BommisettyGanesh/cvw/1tops_soc/src2/README.md

# 1TOPS SoC

A minimal RISC-V SoC based on the [CORE-V-Wally](https://github.com/openhwgroup/cvw) (CVW) processor, tailored for hardware synthesis and accelerator integration. The core runs a bare **rv32i** instruction set — FPU, caches, MDU, branch predictors, TLBs, and crypto/bitmanip extensions have all been stripped out to provide the smallest possible footprint for SoC generation.

## SoC Architecture

The SoC uses an **AHB-Lite** interconnect to connect the pipelined core, uncore peripherals, and a custom hardware accelerator.

```text
                                +-------------------------------------------------------+
                                |                                                       |
                                |                       RV32 Core                       |
                                |                        (rv32i)                        |
                                |                                                       |
                                +---------------------------+---------------------------+
                                                            |
                                                      AHB-Lite Bus
                                                            |
          +-------------------------+-----------------------+-----------------------+-------------------------+
          |                         |                       |                       |                         |
  +-------+-------+         +-------+-------+       +-------+-------+       +-------+-------+         +-------+-------+
  |   Boot ROM    |         |   Instr RAM   |       |   Data RAM    |       |  AHB-to-APB   |         |  Multiplier   |
  | (0x0000_1000) |         | (0x8000_0000) |       | (0x8000_2000) |       |    Bridge     |         | (0x3000_0000) |
  +---------------+         +---------------+       +---------------+       +-------+-------+         +---------------+
                                                                                    |
                                                                                 APB Bus
                                                                                    |
        +-----------------------+-----------------------+---------------------------+---------------------------+-----------------------+
        |                       |                       |                           |                           |                       |
+-------+-------+       +-------+-------+       +-------+-------+           +-------+-------+           +-------+-------+       +-------+-------+
|     UART      |       |     GPIO      |       |      SPI      |           |      SDC      |           |     CLINT     |       |     PLIC      |
| (0x1000_0000) |       | (0x1006_0000) |       | (0x1004_0000) |           | (0x0A00_0000) |           | (0x0200_0000) |       | (0x0C00_0000) |
+---------------+       +---------------+       +---------------+           +---------------+           +---------------+       +---------------+
```

## Memory Map

| Start Address | End Address | Size | Bus | Peripheral |
|---|---|---|-----|---|
| `0x0000_1000` | `0x0000_1FFF` | 4 KB | AHB | Boot ROM |
| `0x0200_0000` | `0x0200_FFFF` | 64 KB  | APB | CLINT (Timer / SW Interrupts)|
| `0x0A00_0000` | `0x0A00_0FFF` | 4 KB | APB | SDC (Debug Unit / Reserved)  |
| `0x0C00_0000` | `0x0FFF_FFFF` | 64 MB  | APB | PLIC (Interrupt Controller)  |
| `0x1000_0000` | `0x1000_0007` | 8 B | APB | UART (16550-compatible) |
| `0x1004_0000` | `0x1004_0FFF` | 4 KB | APB | SPI |
| `0x1006_0000` | `0x1006_00FF` | 256 B  | APB | GPIO |
| `0x3000_0000` | `0x30FF_FFFF` | 16 MB  | AHB | Multiplier Module |
| `0x8000_0000` | `0x8000_1FFF` | 8 KB | AHB | Instruction RAM |
| `0x8000_2000` | `0x8000_3FFF` | 8 KB | AHB | Data RAM |

## Directory Structure

```
1tops_soc/
├── config/              # Configuration headers (config.vh, parameter-defs.vh)
├── fpga/                # Standalone FPGA implementation targeting Digilent Basys 3
│   ├── constrs/         # Physical pin constraints (basys3.xdc)
│   ├── src/             # FPGA-tuned RTL sources (BRAM inference, debugger)
│   ├── top/             # wally_soc_fpga_top.sv top-level wrapper
│   ├── build_fpga.tcl   # Automated Vivado build script
│   └── README.md        # FPGA board guide, HTerm serial terminal setup, and demos
├── schematics/          # Vivado project & TCL scripts for RTL schematic viewing
├── software/            # Bare-metal test programs, linker script, startup code
│   ├── main.c           # Accelerator C test program
│   ├── factorial.S      # Bare-metal RV32I factorial demo for FPGA testing
│   ├── crt0.S           # Startup assembly
│   ├── link.ld          # Linker script
│   └── Makefile
├── src/                 # RTL source (SystemVerilog)
│   ├── accelerator/     # Custom AHB accelerators (multiplier_ahb.sv)
│   ├── debugger/        # Hardware debugger (UART, FT1248, ADP controller, AHB arbiter)
│   ├── ebu/             # External Bus Unit (AHB-Lite arbiter)
│   ├── generic/         # Flops, muxes, memories (ram1p1rwbe.sv)
│   ├── hazard/          # Pipeline hazard unit with ExternalStall core freeze
│   ├── ieu/             # Integer Execution Unit (ALU, controller, regfile)
│   ├── ifu/             # Instruction Fetch Unit
│   ├── lsu/             # Load-Store Unit
│   ├── mmu/             # Memory Management Unit (address decoders, PMA/PMP)
│   ├── privileged/      # CSRs, trap handling, privilege modes
│   ├── uncore/          # SoC peripherals (UART, GPIO, SPI, CLINT, PLIC, RAM, ROM)
│   └── wally/           # Top-level SoC and core wrappers (wallypipelinedsoc.sv)
├── testbench/           # Verilator testbench (tb.sv, sim_main.cpp)
├── filelist.f           # Verilator source file list
├── Makefile             # Top-level build: `make` compiles software + runs simulation
└── README.md
```

## Features

- **Pipelined RISC-V Core**: Minimal rv32i instruction set. No FPU, no caches, no MDU, no branch predictors, no TLBs, no compressed/crypto/bitmanip extensions.
- **Dual-Protocol Hardware Debugger**: Integrated ASCII Debug Protocol (ADP) engine supporting both **UART** (115200 baud on PMOD JA) and **FT1248** (high-speed synchronous bus on PMOD JB) with physical switch selection (`dbg_sel`). Auto-enters ADP command prompt (`]`) on boot without requiring an escape character (`0x1B`).
- **Non-Intrusive Core Freeze & Single-Stepping**: Halts the 5-stage CPU pipeline on the fly via `ExternalStall` in `hazard.sv`, granting full AHB-Lite bus mastership to the debugger through `ahb_mux.sv`. Features a dedicated **Core Step Controller** (`core_step_controller.sv`) for single instruction stepping (`C 0204`) and clock-cycle stepping (`C 020c`).
- **Reconfigurable In-Flight Clock Dividers**: Isolated hardware configuration registers allow dynamic, glitch-free reconfiguration of the UART baud rate divider and FT1248 clock divider via ADP commands `B` and `D`.
- **Subword-Accurate Memory Access**: `HWSTRB` dynamic byte/halfword/word strobe decoding enables clean byte streaming via binary upload (`U`) without corrupting neighboring memory words.
- **Dedicated FPGA Implementation (Basys 3)**: Synthesizes instruction RAM (`ram_i`) and data RAM (`ram_d`) into dedicated hardware `RAMB36E1` Block RAM primitives. Includes synchronous UART RX monitoring and prompt detection on LED 15 (`led_rx_detect`).
- **AHB-Lite Interconnect**: Standard bus interface for attaching IP blocks.
- **External Accelerator Support**: Dedicated AHB region at `0x3000_0000` for custom accelerators (currently a hardware multiplier).
- **Full Uncore**: UART, GPIO, SPI, CLINT, PLIC, Boot ROM, and Independent Instruction/Data RAMs are all present and functional.
- **Independent RAMs**: 16KB total, mapped at `0x8000_0000` (8KB Instruction RAM) and `0x8000_2000` (8KB Data RAM), initialized from `test_instr.mem` and `test_data.mem` during simulation.

## Integrating an Accelerator

Custom accelerators are integrated directly into the SoC as **AHB Slaves** inside the uncore module.

1. **Create an AHB Slave**: Write a SystemVerilog module with an AHB slave interface (see `src/accelerator/multiplier_ahb.sv` for reference).
2. **Instantiate in the Uncore**: Add the module inside `src/uncore/uncore.sv`, connecting to the internal `H*EXT` signals (`HRDATAEXT`, `HSELEXT`, etc.).
3. **Add to filelist**: Add the new `.sv` file path to `filelist.f`.
4. **Access from Software**: Use memory-mapped I/O at `0x3000_0000` in your C code.

### Multiplier Module Registers

| Offset | Register | Description |
|---|---|---|
| `0x00` | OPA | Operand A (write) |
| `0x04` | OPB | Operand B (write) |
| `0x08` | RESULT | Product A×B (read) |
| `0x0C` | PRINT | Debug char out (write)|

## Simulation & Testing

The repository includes a simulation environment using **Verilator**.

### Quick Start

From the root of the repository (`1tops_soc/`):

```bash
make
```

This single command will:
1. Clean and compile `software/main.c` into `test_instr.mem` and `test_data.mem` hex files.
2. Clean and compile the Verilator hardware simulation model.
3. Execute the full SoC testbench and print C code outputs to your terminal.

> [!NOTE]
> **Full SoC Simulation**: The simulation includes the **entire Wally pipelined SoC** — all standard peripherals (PLIC, CLINT, UART, GPIO, SPI) remain intact and fully simulated within the uncore.

### Writing Your Own Test

1. Edit `software/main.c` with your C program.
2. Use `volatile uint32_t*` pointers to `0x3000_0000` to interact with the accelerator.
3. Run `make` from the repo root.

## Viewing RTL Schematics in Vivado

The `schematics/` directory includes scripts to visualize the RTL in Xilinx Vivado:

```bash
cd schematics
./open_vivado.sh
```

This creates a Vivado project, adds all sources, elaborates the RTL, and opens the schematic viewer. See `schematics/README.md` for details.
## 4. Tsetlin Machine Accelerator & Debug Unit Integration

### Tsetlin Machine Integration (`0x3000_0000`)
The system is explicitly designed to act as a bare-metal controller for an external Convolutional Tsetlin Machine.
The accelerator space is mapped to `0x3000_0000` - `0x30FF_FFFF` (16MB).
Because it uses the `EXT_MEM` parameter configuration, any memory access by the core to this region is automatically routed out of the top-level `wallypipelinedsoc.sv` module via the `HSELEXT` and `HRDATAEXT` pins.

We have provided a template accelerator and testbench to show how this is connected:
- **`src/accelerator/tsetlin_ahb_wrapper.sv`**: A mock SystemVerilog AHB peripheral mapped to `0x3000_0000`. You should put your actual Tsetlin Machine logic in this file (or replace it).
- **`filelist.f`**: This manifest includes `src/accelerator/*.sv` so your accelerator is automatically picked up by Vivado and Verilator.
- **`testbench/tb.sv`**: This is the top-level testbench that instantiates both `wallypipelinedsoc` and `tsetlin_ahb_wrapper`, connecting the exported AHB pins (`HSELEXT`, `HADDREXT`, etc.) directly to the accelerator.

### Debug Unit Integration
The `SDC` APB peripheral slot has been repurposed as a placeholder for a custom Debug Unit.
In `src/uncore/uncore.sv`, look for the `debug_unit` block. You can connect your custom debug module directly to the APB bus signals `PSEL[5]`, `PADDR`, `PWDATA`, and `PRDATA[5]` located there.

---

## 5. Software C-Compilation & Verilator Simulation

This repository includes a bare-metal C toolchain scaffold and a Verilator simulator driver so you can write C code, compile it, and run it against the RTL (and your accelerator).

### 1. Writing C Code (`software/`)
The `software/` directory contains everything you need to write and compile code for the `1tops_soc`:
- `main.c`: Your main application. It demonstrates how to print to the UART (`0x1000_0000`) and how to read/write memory-mapped registers in the Tsetlin Accelerator (`0x3000_0000`).
- `link.ld`: A minimal linker script mapping code to the Instruction RAM and data to the Data RAM.
- `crt0.S`: Assembly startup script to initialize the stack and jump to `main`.
- `Makefile`: Uses `riscv64-unknown-elf-gcc` to compile the C files and generates `test_instr.mem` and `test_data.mem` hex files.

### 2. Simulating with Verilator (`testbench/`)
The `testbench/` directory contains a complete simulation environment.

**Prerequisites:**
You need `verilator` and `riscv64-unknown-elf-gcc` installed on your machine.

**Running the Simulation:**
Navigate to the testbench directory and run `make run` (or just `make` from the repository root):
```bash
make
```

**What happens when you type `make`:**
1. It builds the Verilator C++ model of `tb.sv` (which includes the SoC and the Accelerator).
2. It copies the `software/test_instr.mem` and `software/test_data.mem` (your compiled C code) into the testbench directory.
3. It runs the simulation. The internal `ram_ahb.sv` memory modules use `$readmemh` to preload your C code into the Instruction and Data SRAMs.
4. The simulation executes, and a `trace.vcd` waveform is generated (limited to AHB signals to reduce size) for debugging in GTKWave!

---

## 6. Dedicated FPGA Implementation & Hardware Debugger (Basys 3)

The `fpga/` directory provides a ready-to-synthesize implementation for the **Digilent Basys 3** board (`xc7a35tcpg236-1`).

### Physical Hardware Pinout

| Port Name | Board Location | Direction | Function |
| :--- | :--- | :---: | :--- |
| `clk` | **Pin W5** | Input | 100 MHz oscillator (MMCM generates 50 MHz `clk_soc`) |
| `reset_btn` | **Pin U18 (btnC)** | Input | Center pushbutton (active-high system reset) |
| `dbg_sel` | **Pin V17 (SW0)** | Input | Slide switch: `0` (Down) = UART, `1` (Up) = FT1248 |
| `uart_rx` | **PMOD JA Pin 1 (J1)** | Input | Debugger UART RX (connect to USB-UART Dongle TXD) |
| `uart_tx` | **PMOD JA Pin 2 (L2)** | Output | Debugger UART TX (connect to USB-UART Dongle RXD) |
| `ft1248_clk` | **PMOD JB Pin 1 (A14)** | Output | FT1248 Serial Clock (SCLK to FT232H) |
| `ft1248_ss_n` | **PMOD JB Pin 2 (A16)** | Output | FT1248 Active-Low Chip Select (SS# to FT232H) |
| `ft1248_miso` | **PMOD JB Pin 3 (B15)** | Input | FT1248 Read Available Status (MISO / RXF# from FT232H) |
| `ft1248_miosio` | **PMOD JB Pin 4 (B16)** | Inout | FT1248 Bidirectional Serial Data Bus |
| `led_core_halted` | **Pin U16 (LED 0)** | Output | Status LED (lit when CPU core is halted by debugger) |
| `led_dbg_sel` | **Pin E19 (LED 1)** | Output | Status LED (lit when FT1248 mode is selected) |
| `led_rx_detect` | **Pin L1 (LED 15)** | Output | UART RX Activity / Prompt `]` Detector (Blinks ~200ms on any byte, latches ON upon detecting `]`) |

### Serial Terminal Interaction (HTerm)

Configure HTerm with **115200 Baud, 8 Data Bits, 1 Stop Bit, No Parity, No Flow Control**:

1. **Boot Banner & Direct Auto-Prompt**:
   On power-on or pressing reset button `btnC`, the debugger outputs:
   ```text
    0x50c1ab04
   ]
   ```
   LED 15 turns solidly ON. **No escape character (`0x1B`) is required!**

2. **Execute Commands**:
   Set input to **`ASC`** with **Send on Enter = `CR`**:
   - `C 0202` — Halt CPU pipeline (`led_core_halted` turns ON).
   - `C 0204` / `C 0104` — Single-step 1 retired instruction.
   - `C 020c` / `C 010c` — Single-step 1 clock cycle.
   - `C` — Query status (Bit 0 = Halted, Bit 1 = Step Busy, Bit 2 = Step Done).
   - `B` — Query UART and FT1248 clock dividers (`0x00<FT8><UART16>`).
   - `B <hex16>` — Set UART baud divider (e.g., `B 00d9` for 230,400 baud at 50 MHz).
   - `D` / `D <hex8>` — Query / set FT1248 clock divider.
   - `A <hex_addr>` — Set 32-bit AHB address pointer.
   - `R` / `W <data>` — Read or write 32-bit word at current pointer.
   - `F <count>` — Fill `<count>` words with reference value in `V`.
   - `U <count>` — Stream `<count>` raw binary bytes sequentially into memory.
   - `C 0201` / `C 0101` — Assert / deassert CPU reset vector.
   - `C 0102` — Resume CPU pipeline execution.
   - `X` — Exit back to terminal passthrough mode.

### Bare-Metal Factorial Demo (`software/factorial.S`)

To test the core, memory, and debugger end-to-end:
1. Compile the demo: `cd software && make factorial.bin` (produces 76-byte `factorial.bin`).
2. Halt CPU: `C 0202`
3. Zero instruction memory: `A 80000000` $\rightarrow$ `V 00000000` $\rightarrow$ `F 200`
4. Set input $n = 5$ at Data RAM `0x80002000`: `A 80002000` $\rightarrow$ `W 00000005` $\rightarrow$ `W 00000000`
5. Upload program: `A 80000000` $\rightarrow$ `U 4c` $\rightarrow$ send `factorial.bin` via HTerm **Send File**.
6. Restart and run: `C 0201` $\rightarrow$ `C 0101` $\rightarrow$ `C 0102`
7. Halt and check result: `C 0202` $\rightarrow$ `A 80002004` $\rightarrow$ `R` $\rightarrow$ replies `R 0x00000078` ($120_{10} = 5!$).

For detailed guides, see:
- [fpga/README.md](file:///home/ganesh/Desktop/shri/cvw/1tops_soc/fpga/README.md) — Basys 3 board implementation and bitstream build
- [fpga/STEP_AND_CLOCK_DIV_VERIFICATION_GUIDE.md](file:///home/ganesh/Desktop/shri/cvw/1tops_soc/fpga/STEP_AND_CLOCK_DIV_VERIFICATION_GUIDE.md) — Detailed core stepping and clock division verification guide
- [src/debugger/COMMANDS.md](file:///home/ganesh/Desktop/shri/cvw/1tops_soc/src/debugger/COMMANDS.md) — Complete ADP command reference and cheatsheet
