BommisettyGanesh/cvw/1tops_soc/src2/uncore/spi_apb.sv

// spi_apb.sv
// Purpose: SPI peripheral

module spi_apb #(
  parameter XLEN = 32,
  parameter SPI_LOOPBACK_TEST = 0
)(
  input  logic                PCLK, PRESETn,
  input  logic                PSEL,
  input  logic [7:0]          PADDR,
  input  logic [XLEN-1:0]     PWDATA,
  input  logic [XLEN/8-1:0]   PSTRB,
  input  logic                PWRITE,
  input  logic                PENABLE,
  output logic                PREADY,
  output logic [XLEN-1:0]     PRDATA,
  output logic                SPIOut,
  input  logic                SPIIn,
  output logic [3:0]          SPICS,
  output logic                SPIIntr,
  output logic                SPICLK
);

  // register map
  localparam SPI_SCKDIV =  8'h00;
  localparam SPI_SCKMODE = 8'h04;
  localparam SPI_CSID =    8'h10;
  localparam SPI_CSDEF =   8'h14;
  localparam SPI_CSMODE =  8'h18;
  localparam SPI_DELAY0 =  8'h28;
  localparam SPI_DELAY1 =  8'h2C;
  localparam SPI_FMT =     8'h40;
  localparam SPI_TXDATA =  8'h48;
  localparam SPI_RXDATA =  8'h4C;
  localparam SPI_TXMARK =  8'h50;
  localparam SPI_RXMARK =  8'h54;
  localparam SPI_IE =      8'h70;
  localparam SPI_IP =      8'h74;

  // SPI control registers. Refer to SiFive FU540-C000 manual
  logic [11:0] SckDiv;
  logic [1:0]  SckMode;
  logic [1:0]  ChipSelectID;
  logic [3:0]  ChipSelectDef;
  logic [1:0]  ChipSelectMode;
  logic [15:0] Delay0, Delay1;
  logic [4:0]  Format;
  logic [7:0]  ReceiveData;
  logic [8:0]  TransmitData;
  logic [2:0]  TransmitWatermark, ReceiveWatermark;
  logic [1:0]  InterruptEnable, InterruptPending;

  // Bus interface signals
  logic [7:0]  Entry;
  logic        Memwrite;
  logic [31:0] Din,  Dout;

  // SPI Controller signals
  logic        SCLKenable;
  logic        EndOfFrame;
  logic        Transmitting;
  logic        InactiveState;
  logic [3:0]  FrameLength;

  // Starting Transmission and restarting SCLKenable
  logic        ResetSCLKenable;
  logic        TransmitStart;
  logic        TransmitStartD;

  // Transmit Start State Machine Variables
  typedef enum logic [1:0] {READY, START, WAIT} txState;
  txState CurrState, NextState;

  // FIFO Watermark signals - TransmitReadMark = ip[0], ReceiveWriteMark = ip[1]
  logic        TransmitWriteMark, TransmitReadMark, ReceiveWriteMark, ReceiveReadMark;

  // Transmit FIFO Signals
  logic        TransmitFIFOFull, TransmitFIFOEmpty;
  logic        TransmitFIFOWriteInc;
  logic        TransmitFIFOReadInc;                // Increments Tx FIFO read ptr 1 cycle after Tx FIFO is read
  logic [7:0]  TransmitReadData;

  // ReceiveFIFO Signals
  logic        ReceiveFIFOWriteInc;
  logic        ReceiveFIFOReadInc;
  logic        ReceiveFIFOFull, ReceiveFIFOEmpty;

  /* verilator lint_off UNDRIVEN */
  logic [2:0]  TransmitWriteWatermarkLevel, ReceiveReadWatermarkLevel; // unused generic FIFO outputs
  /* verilator lint_on UNDRIVEN */
  logic [7:0]  ReceiveShiftRegEndian;              // Reverses ReceiveShiftReg if Format[2] set (little endian transmission)

  // Shift reg signals
  logic        ShiftEdge;                          // Determines which edge of sck to shift from TransmitReg
  logic        SampleEdge;                         // Determines which edge of sck to sample from ReceiveShiftReg
  logic [7:0]  TransmitReg;                        // Transmit shift register
  logic [7:0]  ReceiveShiftReg;                    // Receive shift register
  logic [7:0]  TransmitDataEndian;                 // Reverses TransmitData from txFIFO if littleendian, since TransmitReg always shifts MSB
  logic        TransmitLoad;                       // Determines when to load TransmitReg
  logic        TransmitRegLoaded;

  // Shift stuff due to Format register?
  logic        ShiftIn;                            // Determines whether to shift from SPIIn or SPIOut (if SPI_LOOPBACK_TEST)
  logic [3:0]  LeftShiftAmount;                    // Determines left shift amount to left-align data when little endian
  logic [7:0]  ASR;                                // AlignedReceiveShiftReg

  // CS signals
  logic [3:0]  ChipSelectAuto;                     // Assigns ChipSelect value to selected CS signal based on CS ID
  logic [3:0]  ChipSelectInternal;                 // Defines what each ChipSelect signal should be based on transmission status and ChipSelectDef

  // APB access
  assign Entry = {PADDR[7:2],2'b00};  //  32-bit word-aligned accesses
  assign Memwrite = PWRITE & PENABLE & PSEL;  // Only write in access phase
  assign PREADY = 1'b1;

  // Account for subword read/write circuitry
  // -- Note SPI registers are 32 bits no matter what; access them with LW SW.

  assign Din = PWDATA[31:0];
  assign PRDATA = (XLEN == 64) ? {Dout, Dout} : Dout;

  // Register access
  always_ff@(posedge PCLK)
    if (~PRESETn) begin
      SckDiv <= 12'd3;
      SckMode <= 2'b0;
      ChipSelectID <= 2'b0;
      ChipSelectDef <= 4'b1111;
      ChipSelectMode <= 2'b0;
      Delay0 <= {8'b1,8'b1};
      Delay1 <= {8'b0,8'b1};
      Format <= {5'b10000};
      TransmitData <= 9'b0;
      TransmitWatermark <= 3'b0;
      ReceiveWatermark <= 3'b0;
      InterruptEnable <= 2'b0;
      InterruptPending <= 2'b0;
    end else begin // writes
      /* verilator lint_off CASEINCOMPLETE */
      if (Memwrite)
        case(Entry) // flop to sample inputs
          SPI_SCKDIV:  SckDiv <= Din[11:0];
          SPI_SCKMODE: SckMode <= Din[1:0];
          SPI_CSID:    ChipSelectID <= Din[1:0];
          SPI_CSDEF:   ChipSelectDef <= Din[3:0];
          SPI_CSMODE:  ChipSelectMode <= Din[1:0];
          SPI_DELAY0:  Delay0 <= {Din[23:16], Din[7:0]};
          SPI_DELAY1:  Delay1 <= {Din[23:16], Din[7:0]};
          SPI_FMT:     Format <= {Din[19:16], Din[2]};
          SPI_TXDATA:  if (~TransmitFIFOFull) TransmitData[7:0] <= Din[7:0];
          SPI_TXMARK:  TransmitWatermark <= Din[2:0];
          SPI_RXMARK:  ReceiveWatermark <= Din[2:0];
          SPI_IE:      InterruptEnable <= Din[1:0];
        endcase
      /* verilator lint_on CASEINCOMPLETE */

      // According to FU540 spec: Once interrupt is pending, it will remain set until number
      // of entries in tx/rx fifo is strictly more/less than tx/rxmark
      InterruptPending[0] <= TransmitReadMark;
      InterruptPending[1] <= ReceiveWriteMark;

      case(Entry) // Flop to sample inputs
        SPI_SCKDIV:  Dout <= {20'b0, SckDiv};
        SPI_SCKMODE: Dout <= {30'b0, SckMode};
        SPI_CSID:    Dout <= {30'b0, ChipSelectID};
        SPI_CSDEF:   Dout <= {28'b0, ChipSelectDef};
        SPI_CSMODE:  Dout <= {30'b0, ChipSelectMode};
        SPI_DELAY0:  Dout <= {8'b0, Delay0[15:8], 8'b0, Delay0[7:0]};
        SPI_DELAY1:  Dout <= {8'b0, Delay1[15:8], 8'b0, Delay1[7:0]};
        SPI_FMT:     Dout <= {12'b0, Format[4:1], 13'b0, Format[0], 2'b0};
        SPI_TXDATA:  Dout <= {TransmitFIFOFull, 23'b0, 8'b0};
        SPI_RXDATA:  Dout <= {ReceiveFIFOEmpty, 23'b0, ReceiveData[7:0]};
        SPI_TXMARK:  Dout <= {29'b0, TransmitWatermark};
        SPI_RXMARK:  Dout <= {29'b0, ReceiveWatermark};
        SPI_IE:      Dout <= {30'b0, InterruptEnable};
        SPI_IP:      Dout <= {30'b0, InterruptPending};
        default:     Dout <= 32'b0;
      endcase
    end

  // SPI Controller module -------------------------------------------
  // This module controls state and timing signals that drive the rest of this module
  assign ResetSCLKenable = Memwrite & (Entry == SPI_SCKDIV);
  assign FrameLength = Format[4:1];

  spi_controller controller(PCLK, PRESETn,
                            // Transmit Signals
                            TransmitStart, TransmitRegLoaded, ResetSCLKenable,
                            // Register Inputs
                            SckDiv, SckMode, ChipSelectMode, Delay0, Delay1, FrameLength,
                            // txFIFO stuff
                            TransmitFIFOEmpty,
                            // Timing
                            SCLKenable, ShiftEdge, SampleEdge, EndOfFrame,
                            // State stuff
                            Transmitting, InactiveState,
                            // Outputs
                            SPICLK);

  // Transmit FIFO ---------------------------------------------------

  // txFIFO write increment logic
  always_ff @(posedge PCLK or negedge PRESETn) begin
    if (~PRESETn) TransmitFIFOWriteInc <= 1'b0;
    else          TransmitFIFOWriteInc <= (Memwrite & (Entry == SPI_TXDATA) & ~TransmitFIFOFull);
  end

  // txFIFO read increment logic
  always_ff @(posedge PCLK or negedge PRESETn) begin
    if (~PRESETn)        TransmitFIFOReadInc <= 1'b0;
    else if (SCLKenable) TransmitFIFOReadInc <= TransmitStartD | (EndOfFrame & ~TransmitFIFOEmpty);
  end

  // Check whether TransmitReg has been loaded.
  // We use this signal to prevent returning to the Ready state for TransmitStart
  always_ff @(posedge PCLK) begin
    if (~PRESETn) begin
      TransmitRegLoaded <= 1'b0;
    end else if (TransmitLoad) begin
      TransmitRegLoaded <= 1'b1;
    end else if (ShiftEdge | EndOfFrame) begin
      TransmitRegLoaded <= 1'b0;
    end
  end

  // Setup TransmitStart state machine
  always_ff @(posedge PCLK)
    if (~PRESETn) CurrState <= READY;
    else          CurrState <= NextState;

  // State machine for starting transmissions
  always_comb begin
    case (CurrState)
      READY: if (~TransmitFIFOEmpty & ~Transmitting) NextState = START;
             else NextState = READY;
      START: NextState = WAIT;
      WAIT: if (~Transmitting & ~TransmitRegLoaded) NextState = READY;
            else NextState = WAIT;
      default: NextState = READY;
    endcase
  end

  // Delayed TransmitStart signal for incrementing tx read point.
  assign TransmitStart = (CurrState == START);
  always_ff @(posedge PCLK)
    if (~PRESETn) TransmitStartD <= 1'b0;
    else if (TransmitStart) TransmitStartD <= 1'b1;
    else if (SCLKenable) TransmitStartD <= 1'b0;

  // Transmit FIFO
  spi_fifo #(3,8) txFIFO(PCLK, 1'b1, SCLKenable, PRESETn,
                         TransmitFIFOWriteInc, TransmitFIFOReadInc,
                         TransmitData[7:0],
                         TransmitWriteWatermarkLevel, TransmitWatermark[2:0],
                         TransmitReadData[7:0],
                         TransmitFIFOFull,
                         TransmitFIFOEmpty,
                         TransmitWriteMark, TransmitReadMark);

  // Receive FIFO ----------------------------------------------------

  // Receive FIFO Read Increment register
  always_ff @(posedge PCLK or negedge PRESETn) begin
    if (~PRESETn) ReceiveFIFOReadInc <= 1'b0;
    else          ReceiveFIFOReadInc <= ((Entry == SPI_RXDATA) & ~ReceiveFIFOEmpty & PSEL & ~ReceiveFIFOReadInc);
  end

  // Receive FIFO Write Increment register
  always_ff @(posedge PCLK or negedge PRESETn) begin
    if (~PRESETn)        ReceiveFIFOWriteInc <= 1'b0;
    else if (SCLKenable) ReceiveFIFOWriteInc <= EndOfFrame;
  end

  // Receive FIFO
  spi_fifo #(3,8) rxFIFO(PCLK, SCLKenable, 1'b1, PRESETn,
                         ReceiveFIFOWriteInc, ReceiveFIFOReadInc,
                         ReceiveShiftRegEndian, ReceiveWatermark[2:0],
                         ReceiveReadWatermarkLevel,
                         ReceiveData[7:0],
                         ReceiveFIFOFull,
                         ReceiveFIFOEmpty,
                         ReceiveWriteMark, ReceiveReadMark);

  // Shift Registers --------------------------------------------------
  // Transmit shift register
  assign TransmitLoad = TransmitStart | (EndOfFrame & ~TransmitFIFOEmpty);
  wire [7:0] TransmitReadDataReversed = {TransmitReadData[0], TransmitReadData[1], TransmitReadData[2], TransmitReadData[3],
                                         TransmitReadData[4], TransmitReadData[5], TransmitReadData[6], TransmitReadData[7]};
  assign TransmitDataEndian = Format[0] ? TransmitReadDataReversed : TransmitReadData[7:0];
  always_ff @(posedge PCLK)
    if(~PRESETn)            TransmitReg <= 8'b0;
    else if (TransmitLoad)  TransmitReg <= TransmitDataEndian;
    else if (ShiftEdge)     TransmitReg <= {TransmitReg[6:0], TransmitReg[0]};

  assign SPIOut = TransmitReg[7];

  // If in loopback mode, receive shift register is connected directly
  // to module's output pins. Else, connected to SPIIn. There are no
  // setup/hold time issues because transmit shift register and receive
  // shift register always shift/sample on opposite edges
  assign ShiftIn = SPI_LOOPBACK_TEST ? SPIOut : SPIIn;

  // Receive shift register
  always_ff @(posedge PCLK)
    if(~PRESETn) begin
      ReceiveShiftReg <= 8'b0;
    end else if (SampleEdge) begin
      ReceiveShiftReg <= {ReceiveShiftReg[6:0], ShiftIn};
    end

  // Aligns received data and reverses if little-endian
  assign LeftShiftAmount = 4'h8 - FrameLength;
  assign ASR = ReceiveShiftReg << LeftShiftAmount[2:0];
  wire [7:0] ASRReversed = {ASR[0], ASR[1], ASR[2], ASR[3], ASR[4], ASR[5], ASR[6], ASR[7]};
  assign ReceiveShiftRegEndian = Format[0] ? ASRReversed : ASR[7:0];

  // Interrupt logic: raise interrupt if any enabled interrupts are pending
  assign SPIIntr = |(InterruptPending & InterruptEnable);

  // Chip select logic
  assign ChipSelectInternal = InactiveState ? ChipSelectDef : ~ChipSelectDef;
  always_comb
    case(ChipSelectID[1:0])
      2'b00: ChipSelectAuto = {ChipSelectDef[3], ChipSelectDef[2], ChipSelectDef[1], ChipSelectInternal[0]};
      2'b01: ChipSelectAuto = {ChipSelectDef[3],ChipSelectDef[2], ChipSelectInternal[1], ChipSelectDef[0]};
      2'b10: ChipSelectAuto = {ChipSelectDef[3],ChipSelectInternal[2], ChipSelectDef[1], ChipSelectDef[0]};
      2'b11: ChipSelectAuto = {ChipSelectInternal[3],ChipSelectDef[2], ChipSelectDef[1], ChipSelectDef[0]};
    endcase
  assign SPICS = ChipSelectMode[0] ? ChipSelectDef : ChipSelectAuto;

endmodule
