BommisettyGanesh/cvw/1tops_soc/fpga/src/generic/mem/ram1p1rwbe.sv

///////////////////////////////////////////
// ram1p1r2be.sv
// 1 port sram with byte enables
//
// Written: rose@rosethompson.net
// Created: 3 May 2021
// Modified: 20 January 2023
//
// Purpose: Storage and read/write access to data cache data, tag valid, dirty, and replacement.
//          Basic sram with 1 read write port.
//          When clk rises Addr and LineWriteData are sampled.
//          Following the clk edge read data is output from the sampled Addr.
//
// Documentation:
//
// A component of the CORE-V-WALLY configurable RISC-V project.
// https://github.com/openhwgroup/cvw
//
// Copyright (C) 2021-23 Harvey Mudd College & Oklahoma State University
//
// SPDX-License-Identifier: Apache-2.0 WITH SHL-2.1
//
// Licensed under the Solderpad Hardware License v 2.1 (the “License”); you may not use this file
// except in compliance with the License, or, at your option, the Apache License version 2.0. You
// may obtain a copy of the License at
//
// https://solderpad.org/licenses/SHL-2.1/
//
// Unless required by applicable law or agreed to in writing, any work distributed under the
// License is distributed on an “AS IS” BASIS, WITHOUT WARRANTIES OR CONDITIONS OF ANY KIND,
// either express or implied. See the License for the specific language governing permissions
// and limitations under the License.
////////////////////////////////////////////////////////////////////////////////////////////////

// WIDTH is number of bits in one "word" of the memory, DEPTH is number of such words

module ram1p1rwbe import cvw::*; #(parameter USE_SRAM=0, DEPTH=64, WIDTH=44, PRELOAD_ENABLED=0, string MEMFILE="test.mem") (
  input logic                     clk,
  input logic                     ce,
  input logic [$clog2(DEPTH)-1:0] addr,
  input logic [WIDTH-1:0]         din,
  input logic                     we,
  input logic [(WIDTH-1)/8:0]     bwe,
  output logic [WIDTH-1:0]        dout
);

  ///////////////////////////////////////////////////////////////////////////////
  // TRUE SRAM macro
  ///////////////////////////////////////////////////////////////////////////////
  if ((USE_SRAM == 1) & (WIDTH == 128) & (DEPTH == 64)) begin // Cache data subarray
    genvar index;
    // 64 x 128-bit SRAM
    logic [WIDTH-1:0] BitWriteMask;
    for (index=0; index < WIDTH; index++)
      assign BitWriteMask[index] = bwe[index/8];
    ram1p1rwbe_64x128 sram1A (.CLK(clk), .CEB(~ce), .WEB(~we),
      .A(addr), .D(din),
      .BWEB(~BitWriteMask), .Q(dout));

  end else if ((USE_SRAM == 1) & (WIDTH == 44)  & (DEPTH == 64)) begin // RV64 cache tag
    genvar index;
    // 64 x 44-bit SRAM
    logic [WIDTH-1:0] BitWriteMask;
    for (index=0; index < WIDTH; index++)
      assign BitWriteMask[index] = bwe[index/8];
    ram1p1rwbe_64x44 sram1B (.CLK(clk), .CEB(~ce), .WEB(~we),
      .A(addr), .D(din),
      .BWEB(~BitWriteMask), .Q(dout));

  end else if ((USE_SRAM == 1) & (WIDTH == 22)  & (DEPTH == 64)) begin // RV32 cache tag
    genvar index;
    // 64 x 22-bit SRAM
    logic [WIDTH-1:0] BitWriteMask;
    for (index=0; index < WIDTH; index++)
      assign BitWriteMask[index] = bwe[index/8];
    ram1p1rwbe_64x22 sram1B (.CLK(clk), .CEB(~ce), .WEB(~we),
      .A(addr), .D(din),
      .BWEB(~BitWriteMask), .Q(dout));

    ///////////////////////////////////////////////////////////////////////////////
    // READ first SRAM model
    ///////////////////////////////////////////////////////////////////////////////
  end else begin : ram
    (* ram_style = "block" *) logic [WIDTH-1:0] RAM[DEPTH-1:0];

    // if (PRELOAD_ENABLED) begin
    //   initial begin
    //     RAM[0] = 64'h00600100d2e3ca40;
    //   end
    // end

    `ifdef VERILATOR
      import "DPI-C" function string getenvval(input string env_name);
    `endif

    `ifndef SYNTHESIS
    initial begin
      if (PRELOAD_ENABLED) begin
        if (WIDTH == 64 || WIDTH == 32) begin
          $readmemh(MEMFILE, RAM, 0);  // load RAM for simulation
        end else begin // put something in the RAM so it is not optimized away
          RAM[0] = 'h00002197;
        end
      end
    end
    `endif

    // FPGA-Tuned True Synchronous Block RAM Read and Byte-Write Enables
    // Synthesizes cleanly into Xilinx Artix-7 RAMB36E1 / RAMB18E1 primitives
    logic [WIDTH-1:0] dout_reg;
    integer i;

    always @(posedge clk) begin
      if (ce) begin
        if (we) begin
          for (i = 0; i < WIDTH/8; i = i + 1) begin
            if (bwe[i]) RAM[addr][i*8 +: 8] <= din[i*8 +: 8];
          end
        end
        dout_reg <= RAM[addr];
      end
    end

    if (WIDTH % 8 != 0) begin : gen_rem
      always @(posedge clk) begin
        if (ce && we && bwe[WIDTH/8])
          RAM[addr][WIDTH-1 : WIDTH - (WIDTH % 8)] <= din[WIDTH-1 : WIDTH - (WIDTH % 8)];
      end
    end


    assign dout = dout_reg;
  end

endmodule
