BommisettyGanesh/cvw/1tops_soc/fpga/src/components/mux4.v

module mux4 #(parameter WIDTH = 8) (
    input       [WIDTH-1:0] d0, d1, d2, d3,
    input       [1:0] sel,
    output      [WIDTH-1:0] y
);

assign y = sel[1] ? (sel[0] ? d3 : d2) : (sel[0] ? d1 : d0);

endmodule
