BommisettyGanesh/cvw/1tops_soc/fpga/src/main/pipelined/instr_mem.v

module instr_mem #(parameter DATA_WIDTH = 32, ADDR_WIDTH = 32, MEM_SIZE = 512) (
    input       [ADDR_WIDTH-1:0] instr_addr,
    output      [DATA_WIDTH-1:0] instr
);

// array of 64 32-bit words or instructions
reg [DATA_WIDTH-1:0] instr_ram [0:MEM_SIZE-1];

initial begin
    $readmemh("/home/ganesh/Desktop/riscv/riscv_pipelined_quartus/testcodes/rv32i_test.hex", instr_ram);
end

// word-aligned memory access
// combinational read logic
assign instr = instr_ram[instr_addr[10:2]];

endmodule
