BommisettyGanesh/cvw/1tops_soc/fpga/src/core/components/mux2.v

`ifndef MUX2_DEFINED
`define MUX2_DEFINED
module mux2 #(parameter WIDTH = 8) (
    input       [WIDTH-1:0] d0, d1,
    input       sel,
    output      [WIDTH-1:0] y
);

assign y = sel ? d1 : d0;

endmodule
`endif
