BommisettyGanesh/cvw/1tops_soc/fpga/src/core/components/mux3.v

`ifndef MUX3_DEFINED
`define MUX3_DEFINED
module mux3 #(parameter WIDTH = 8) (
    input       [WIDTH-1:0] d0, d1, d2,
    input       [1:0] sel,
    output      [WIDTH-1:0] y
);

assign y = sel[1] ? d2: (sel[0] ? d1 : d0);

endmodule
`endif
