BommisettyGanesh/cvw/(commit log)

2026-08-09 Added sample_1 RTL package, my_minimal_rv32 core config, and bare-metal test application
2026-08-09 Update sample_1 README with AHB DMA controller hardware design and driver instructions
2026-08-09 Add 32-bit hardware multiplier accelerator module, bare-metal C test driver, and update documentation
2026-08-09 Add Vivado schematics setup and dynamic elaboration for sample_1
2026-08-30 removed DMA
2026-08-30 Mass cleanup: Keep only 1tops_soc RTL and Vivado script
    [bestSynths.csv, expected_coremark_results.csv, ppaData.csv, ppaEquations.csv, ppaFitting.csv]
2026-08-30 Remove RTL-to-GDS flow documentation
2026-10-05 tested debugger with uart
2026-10-12 debugger tested through UART on basys3
2026-10-14 connected uart pins to ft2232 for testing
2026-10-15 built test for trap interrupt
2026-10-15 updated spi test over debugger logic
2026-10-25 netlist view of circuit using rtlvisionpro
